nattse/ReversalLearning/testing/config.xlsx

Settings:
Right Lever Out | yes | yes | yes
Right Lever Reward % | 100 | 100 | 100
Left Lever Out | yes | yes | yes
Left Lever Reward % | 100 | 100 | 100
Presses to trigger right lever | 2 | 2 | 2
Presses to trigger left lever | 2 | 2 | 2
Max rewarded consecutive presses | 5 | 5 | 5
Switch stage at:
Number of presses | 2 | 1 | 1
Duration | -1 | -1 | -1
System:
Arduino ID Port | 0
Cam ID | 4
Filepath | /Users/nathanieltse/Desktop/instrumentlearning/8-29-23_reversal_learning
Advanced:
Lever Timeout | -1
IR Timeout | 1
