nattse/ReversalLearning/(commit log)

2023-03-23 Update combined_recieve_and_execute.ino
    converted to using seconds for check_step() (don't even think about using minutes, unsigned long divided by an integer as large as 60 * 1000 doesn't work and breaking it into steps is more work than it is worth)
    Also gives a readout of exactly what you're printing back to python during the send_and_check phase b/c at one point the Arduino just kept failing to send back what we gave to it and it turned out I tried to send a step duration value in ms and it was so large it wrapped back around as an int, which ended up as a negative value.
    Also tells when food reward is dispensed.
    [combined_recieve_and_execute.ino]
2023-03-23 Update README.md
    Added wiring diagram section
2023-03-23 Update README.md
    Overview added, chamber image added
2023-05-19 Update working_send_and_recieve.py
    adapted for IR camera use
2023-05-19 Update combined_recieve_and_execute.ino
    updated for IR camera use
2023-07-15 Update combined_recieve_and_execute.ino
    small fix to last commit
    [combined_recieve_and_execute.ino]
2023-07-19 Update combined_recieve_and_execute.ino
    Created multi-press scheme, improved false lever-press mitigation, added food bin LED control
2023-07-21 Add files via upload
    variable max presses
    [config.csv]
2023-08-30 Update combined_recieve_and_execute.ino
    fix issue where next step wouldn't actually do anything but print the words and would miss the complete end step
    [combined_recieve_and_execute.ino]
2023-09-11 Update combined_recieve_and_execute.ino
    Fix counting issue and puts completion checking in check_switch
    [combined_recieve_and_execute.ino]
