nattse/ReversalLearning/docs/shield_bottom_wired.jpg

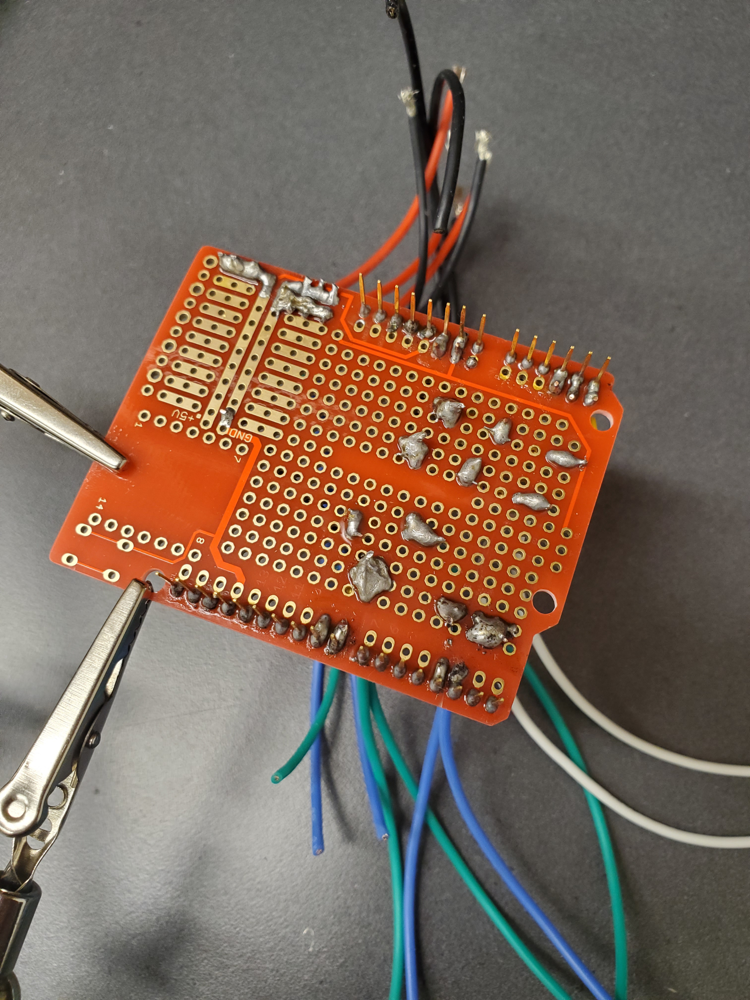
docs/shield_bottom_wired.jpg
