nattse/ReversalLearning/docs/shield_top_unwired.jpg

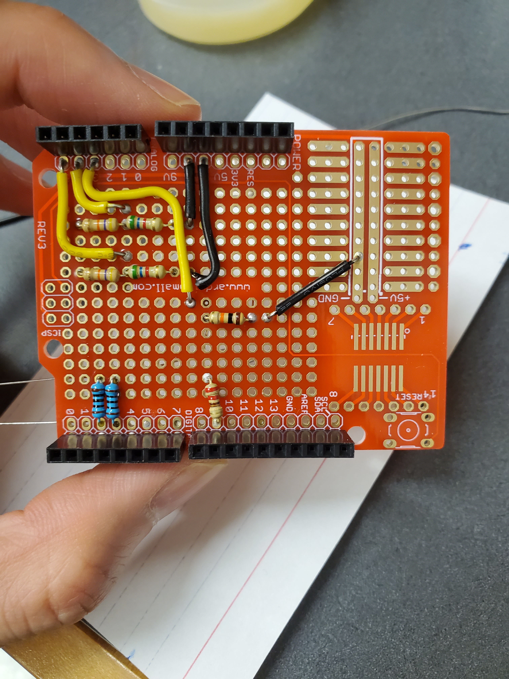
docs/shield_top_unwired.jpg
