nattse/ReversalLearning/docs/chamber_image.jpeg

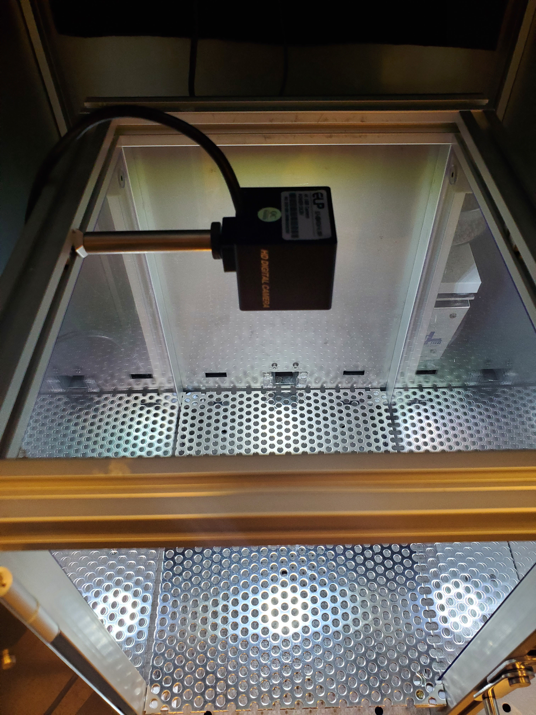
[picture p6: docs/chamber_image.jpeg]
docs/chamber_image.jpeg
